WirtzRaphael/thesis_sensornode/sensornode_v2.0.X-HW/project_output/bom/bill_of_material_sensornode_v2_orderlist.xlsx

Name | Value | Designator | Footprint | LibRef | Quantity | Supplier 1 | Supplier Part Number 1 | Supplier Unit Price 1 | Quantity 4PCB’s | Price | Order 2736: Mouser | Order 2737: Digikey | Vorhanden 05-06
Battery |  | B200 | JST-S2B-PH-K-S_V - Cloned | Battery | 1 |  |  |  |  | 0
1µF | 1µF | C200, C201, C206, C208, C301, C309 | 0402, 0603 | C | 6 | Mouser | 581-04026D105KAT2A | 0.035 | 24 | 0.84 | x
Capacitor 0402 | 10uF | C202 | 0603 | C | 1 | Mouser | 81-GRM188R60J106KE7J | 0.1 | 4 | 0.4 | x
Capacitor 0603 | 22uF | C203, C204 | 0603 | C | 2 | Mouser | 81-GRM188R60J226ME0D | 0.15 | 8 | 1.2 | x
100nF, [NoValue] | 100nF | C205, C207, C209, C313, C314, C315, C316, C317, C318, C400, C401 | 0603 | C | 11 | Mouser | 80-C0603C104K9R | 0.055 | 44 | 2.42 | 0
Capacitor 0402 | 100nF | C210, C300, C302, C303, C304, C305, C306, C307, C308, C310, C311 | 0402 | C | 11 | Mouser | 581-0402X7R104KT7AT | 0.172 | 44 | 7.568 | x
Capacitor 0603 | 100nF | C700, C701, C702, C703, C704 | 0603 | C | 5 | Mouser | 80-C0603X104K1RAUTO | 0.24 | 20 | 4.8 | 0
PMEG2010ER | PMEG2010ER | D200, D202 | SODFL3517X110N | Schotky_1 | 2 | Mouser | 771-PMEG2010ER115 | 0.4 | 8 | 3.2 | x
Orange |  | D201, D401 | 0603-Diode | LED_1 | 2 | Mouser | 630-HSMD-C191 | 0.46 | 8 | 3.68 | x
BAS40-05 | BAS40-05 | D203 | SOT-23 | Schotky_BAS40-5 | 1 | Mouser | 726-BAS4005E6327HTSA | 0.33 | 4 | 1.32 | x
Red |  | D400, D802 | 0603-Diode | LED_1 | 2 | Mouser | 630-HSMC-C191 | 0.61 | 8 | 4.88 | x
Green |  | D800 | 0603-Diode | LED_1 | 1 | Mouser | 630-HSMG-C191 | 0.4 | 4 | 1.6 | x
750mA |  | F800 | 1206 | FUSE_1 | 1 | Mouser | 652-MF-NSMF075/8X-2 | 0.6 | 4 | 2.4 | x
HEADER_2x1_TD |  | J200, J201, J202, J203, J204 | HEADER_2_RM_2.54 | HEADER_2x1_TD | 5 |  |  |  | 20 | 0 | 0
RF_LPRS_x2 |  | J400 |  | RF_LPRS_x2 | 1 | Mouser | 471-SMARACONNECTORWP | 7.38 | 4 | 29.52 | x
HEADER_5x2_LR |  | J402, J804 | HEADER_SMD_1.27 | HEADER_5x2_LR | 2 | Mouser | 710-62101021021 | 1.4 | 8 | 11.2 | x
I2C - TMP117 |  | J600_TEMP1, J600_TEMP2 | JST_S4B-PH-K-S(LF)(SN) | CON4 | 2 |  |  |  | 8 | 0 | 0
CON3 |  | J700 | JST_S3B-PH-K-S(LF)(SN) | CON3 | 1 |  |  |  | 4 | 0 | 0
USB-C | USB4105-GF-A | J800 | USB_GCT_4105-GF-A | USB-C_2 | 1 | Mouser | 640-USB4105-GF-A | 0.827 | 4 | 3.308 | x
0.47uH |  | L200 | FP-XFL4015-MFG | L? | 1 | Mouser | 81-1276AS-H-R47MP2 | 0.4 | 4 | 1.6 | x
BLM18SG331TN1 |  | L201 | 1608X65N_BEADC | L? | 1 | Mouser | 81-BLM18SG331TN1D | 0.13 | 4 | 0.52 | x
M3 | M3 | MTH100, MTH101, MTH102, MTH103 |  | MOUNT_TH | 4 |  |  |  | 16 | 0 | 0
DMP3099LQ |  | Q200 | SOT-23 - FET | MOSFET P | 1 | Mouser | 621-DMP3099LQ-7 | 0.35 | 4 | 1.4 | x
270 | 270 | R200 | 0603 | R? | 1 | Mouser | 667-ERA-3AED271V | 0.17 | 4 | 0.68
511k |  | R201 | 0603 | R? | 1 | Mouser | 71-CRCW0603-511K-E3 | 0.1 | 4 | 0.4
91k |  | R202 | 0603 | R? | 1 | Mouser | 667-ERA-3AED913V | 0.12 | 4 | 0.48
24k |  | R203 | 0603 | R? | 1 |  |  |  | 4 | 0
1k5 |  | R204 | 0603 | R? | 1 | Mouser | 667-ERA-3AED152V | 0.12 | 4 | 0.48
8.2k |  | R205 | 0603 | R? | 1 | Mouser | 667-ERA-3AED822V | 0.12 | 4 | 0.48
10k |  | R206, R210 | 0603 | R? | 2 | Mouser | 667-ERA-2ARB103X | 0.73 | 8 | 5.84
100k |  | R207, R209, R213, R305 | 0603 | R? | 4 | Mouser | 667-ERA-3AED104V | 0.12 | 16 | 1.92
330k |  | R214 | 0603 | R? | 1 | Mouser | 667-ERA-3AEB334V | 0.13 | 4 | 0.52
DNP |  | R300, R301, R303, R304 | 0603 | R? | 4 |  |  |  | 16 | 0
27 |  | R306, R307 | 0603 | R? | 2 | Mouser | 667-ERA-3AHD270V | 0.12 | 8 | 0.96
4k7 |  | R308, R309 | 0603 | R? | 2 | Mouser | 667-ERA-3AED472V | 0.12 | 8 | 0.96
1k |  | R310 | 0603 | R? | 1 | Mouser | 667-ERA-3AED102V | 0.14 | 4 | 0.56
5k6 |  | R400 | 0603 | R? | 1 | Mouser | 667-ERA-3AEB562V | 0.13 | 4 | 0.52
8k2 (DNP) |  | R401 | 0603 | R? | 1 | Mouser | 667-ERA-3AED822V | 0.12 | 4 | 0.48
0 |  | R402 | 0603 | R? | 1 |  |  |  | 4 | 0
150 DNP |  | R403, R404 | 0603 | R? | 2 | Mouser | 667-ERA-3AEB151V | 0.13 | 8 | 1.04
5k1 |  | R803, R804 | 0603 | R? | 2 | Digikey | P5.1KDBCT-ND | 0.13 | 8 | 1.04
120 | 120 | R805, R807 | 0603 | R? | 2 |  |  |  | 8 | 0
BOOTSEL |  | SW300 | SWITCH_B3FS1010P | SW_TACTILE_1 | 1 | Mouser | 653-B3FS-1010P | 0.64 | 4 | 2.56 | x
B3U-1000P-B |  | SW400 | OMRON-B3U-1000P-2-B_V | CMP-011-00011-1 | 1 | Mouser | 653-B3U-1000P-B | 1.02 | 4 | 4.08 | x
SW_TACTILE_1 |  | SW800, SW801 | SWITCH_B3FS1010P | SW_TACTILE_1 | 2 | Mouser | 653-B3FS-1010P | 0.64 | 8 | 5.12 | x
TP_SMD |  | TP202, TP203, TP300, TP301 | TP+245X165 | Testpoint | 4 | Mouser | 279-RCT-0C | 0.23 | 16 | 3.68 | x
IC_BQ25172DSGR |  | U200 | IC_BQ25172DSGR | IC_BQ25172DSGR | 1 | Mouser | 595-BQ25172DSGR | 0.94 | 4 | 3.76 | x
TPS63802DLAR |  | U201 | VREG_TPS63802DLAR | TPS63802DLAR | 1 | Mouser | 595-TPS63802DLAR | 2.5 | 4 | 10 | x
TPS22860DBVR |  | U202 | SOT95P280X145-6N | TPS22860DBVR | 1 | Mouser | 595-TPS22860DBVR | 0.95 | 4 | 3.8 | x
SN74AUP1G32 | SN74AUP1G32 | U203 | SOT23-5 | Gatter OR1x2_1 SN74AUP1G32 | 1 | Mouser | 595-SN74AUP1G32DCKR | 0.4 | 4 | 1.6 | x
TPS22908 | TPS22908 | U204 | BGA4C50P2X2_88X88X62N | TPS22908 | 1 | Mouser | 595-TPS22908YZTT | 1.27 | 4 | 5.08 | x
PCF85063ATL/1,118 |  | U205 | 10-DFN(2.6X2.6) | PCF85063ATL/1,118 | 1 | Mouser | 771-PCF85063ATL1118 | 0.94 | 4 | 3.76 | 0
TCA9406 |  | U300 | VSSOP_SOP50P310X90-8N | IC_TCA9406 | 1 | Mouser | 595-TCA9406DCUR | 0.93 | 4 | 3.72 | x
RP2040_2 |  | U301 | QFN40P700X700X90-57N | RP2040_2 | 1 | Mouser | 358-SC09147 | 0.8 | 4 | 3.2 | 0 |  | 5
W25Q16JVUXIQ |  | U302 | SON50P300X200X60-9N | W25Q16JVUXIQ | 1 |  |  |  | 4 | 0 | 0 |  | 5
TXU0102PWR |  | U303 | VFSOP-8 | IC_TXU0102 | 1 | Mouser | 595-TXU0102DCUR | 0.84 | 4 | 3.36 | x
TXU0104PWR |  | U304 | TSSOP-14 | IC_TXU0204_TSSOP | 1 | Mouser | 595-TXU0104PWR | 0.83 | 4 | 3.32 | x
RC1701HP-RC232 |  | U400 | RF_RC1701HP | RC1701HP-RC232 | 1 | Digikey | 1783-RC1701HP-RC232CT-ND | 30.45 | 4 | 121.8 | 3 | x | 1
MAX3221 SSOP |  | U700 | SSOP_SOP65P780X200-16N | RS232_MAX3221E_TI_TSSOP | 1 | Mouser | 595-MAX3221IDBR | 0.83 | 4 | 3.32 | x
ESD_USBLC6-2SC6_1 |  | U800 | SOT95P280X145-6N | ESD_USBLC6-2SC6_1 | 1 | Mouser | 511-USBLC6-2SC6 | 0.35 | 4 | 1.4 | x
SC32S-7PF20PPM | SC32S-7PF20PPM | Y200 | SC32S7PF20PPM | Crystal_1 | 1 | Mouser | 628-SC32S-7PF20PPM | 0.38 | 4 | 1.52 | x
CSTNE12M0GH5L000R0 | CSTNE12M0GH5L000R0 | Y300 | OSC_CSTNE12M0GH5L000R0 | Crystal_3 | 1 | Mouser | 81-CSTNE12M0GH5L000R | 0.3337 | 4 | 1.3348 | x
 |  |  |  |  |  |  |  | 0 |  | 284.6308
