WirtzRaphael/thesis_sensornode/sensornode_v2.0.X-HW/project_output/bom/bill_of_material_sensornode_v2.xlsx

Name | Description | value | Footprint | Quantity | Manufacturer 1 | Manufacturer Part Number 1 | Manufacturer 2 | Manufacturer Part Number 2 | Supplier Subtotal 2 | Designator
Battery |  |  | HEADER_2_RM_2.54 | 1 |  |  |  |  |  | B200
1µF | Capacitor 0402 | 1µF | 0402 | 6 | jlcpcb | C162161 |  |  |  | C200, C201, C206, C208, C301, C309
Capacitor 0402 | Capacitor 0402 | 10uF | 0603 | 1 |  |  |  |  |  | C202
Capacitor 0603 |  | 22uF | 0603 | 2 |  |  |  |  |  | C203, C204
100n | Capacitor 0402 | 100n | 0603 | 1 |  |  |  |  |  | C205
100nF, Capacitor 0402 | Capacitor 0402 | 100nF | 0402 | 21 | jlcpcb | C363530 |  |  |  | C207, C209, C210, C300, C302, C303, C304, C305, C306, C307, C308, C310, C311, C312, C313, C314, C315, C316, C317, C400, C401
Capacitor 0603 | Capacitor 0603 | 100nF | 0603 | 5 |  |  |  |  |  | C700, C701, C702, C703, C704
PMEG2010ER |  | PMEG2010ER | SODFL3517X110N | 2 | jlcpcb | C82288 |  |  |  | D200, D202
TBD |  |  | 0603-Diode | 1 |  |  |  |  |  | D201
BAS40-05 |  | BAS40-05 | SOT-23 | 1 | Infineon | BAS40-05E-6327 |  |  |  | D203
White |  |  | 0603-Diode | 2 | jlcpcb | none |  |  |  | D400, D802
Orange |  |  | 0603-Diode | 2 | jlcpcb | C601658 |  |  |  | D401, D801
Green |  |  | 0603-Diode | 1 | jlcpcb | C125094 |  |  |  | D800
HEADER_2x1_TD |  |  | HEADER_2_RM_2.54 | 9 |  |  |  |  |  | J200, J201, J202, J203, J204, J400, J801, J802, J803
HEADER_5x2_LR |  |  | CON_2x5_RM1.27_tht | 2 |  |  |  |  |  | J402, J804
I2C - TMP117 |  |  | HEADER_4_RM_2.54 | 2 |  |  |  |  |  | J600_TEMP1, J600_TEMP2
RS232 |  |  | HEADER_2_RM_2.54 | 1 |  |  |  |  |  | J700
USB-C | Connector 24 (16+8 Dummy) | USB4105-GF-A | USB_GCT_4105-GF-A | 1 | jlcpcb | C3020560 |  |  |  | J800
0.47uH |  |  | FP-XFL4015-MFG | 1 | jlcpcb | C2044584 |  |  |  | L200
BLM18SG331TN1 | 330 Ohms @ 100 MHz 1 Power Line Ferrite Bead 0603 (1608 Metric) 1.5A 70mOhm |  | 1608X65N_BEADC | 1 | jlcpcb | C88989 |  |  |  | L201
M3 |  | M3 |  | 4 | jlcpcb | none |  |  |  | MTH100, MTH101, MTH102, MTH103
DMP3099LQ |  |  | SOT-23 - FET | 1 |  |  |  |  |  | Q200
TBD | Normaler Widerstand |  | 0603 | 3 |  |  |  |  |  | R200, R805, R806
511k | Normaler Widerstand |  | 0603 | 1 |  |  |  |  |  | R201
91k | Normaler Widerstand |  | 0603 | 1 |  |  |  |  |  | R202
24k | Normaler Widerstand |  | 0603 | 1 |  |  |  |  |  | R203
1k5 | Normaler Widerstand |  | 0603 | 1 |  |  |  |  |  | R204
8.2k | Normaler Widerstand |  | 0603 | 1 |  |  |  |  |  | R205
10k | Normaler Widerstand |  | 0603 | 6 |  |  |  |  |  | R206, R210, R211, R800, R801, R802
100k | Normaler Widerstand |  | 0603 | 4 |  |  |  |  |  | R207, R209, R213, R305
DNP | Normaler Widerstand |  | 0603 | 6 |  |  |  |  |  | R208, R212, R300, R301, R303, R304
330k | Normaler Widerstand |  | 0603 | 1 |  |  |  |  |  | R214
5k1 | Normaler Widerstand |  | 0603 | 3 |  |  |  |  |  | R302, R803, R804
27 | Normaler Widerstand |  | 0603 | 2 |  |  |  |  |  | R306, R307
4k7 | Normaler Widerstand |  | 0603 | 2 |  |  |  |  |  | R308, R309
1k | Normaler Widerstand |  | 0603 | 1 |  |  |  |  |  | R310
5k6 | Normaler Widerstand |  | 0603 | 1 |  |  |  |  |  | R400
8k2 (DNP) | Normaler Widerstand |  | 0603 | 1 |  |  |  |  |  | R401
0 | Normaler Widerstand |  | 0603 | 1 |  |  |  |  |  | R402
150 DNP | Normaler Widerstand |  | 0603 | 2 |  |  |  |  |  | R403, R404
68 | Normaler Widerstand |  | 0603 | 1 |  |  |  |  |  | R807
Bootsel, B3U-1000P-B | Ultra-small Surface-mounting Tactile Switches with High Contact Reliability, SPST-NO, -25 to 70 degC, 2-Pin SMD, RoHS, Tape and Reel |  | OMRON-B3U-1000P-2-B_V | 2 | jlcpcb | C231329 |  |  |  | SW300, SW400
TP_SMD | Testpoint |  | TP+245X165 | 4 | jlcpcb | C9900017596 |  |  |  | TP200, TP201, TP300, TP301
IC_BQ25172DSGR | Charge IC. 0.8-A, one- to six-cell NiMH stand-alone linear charger in a QFN package |  | IC_BQ25172DSGR | 1 | jlcpcb | C5189434 |  |  |  | U200
TPS63802DLAR |  |  | VREG_TPS63802DLAR | 1 | jlcpcb | C2845237 |  |  |  | U201
TPS22919DCKR | 5.5-V, 1.5-A, 90-mΩ load switch with adj. output discharge | TPS22919DCKR | SOT65P210X110-6N | 2 | jlcpcb | C2149796 |  |  |  | U202, U204
SN74LVC1T45 |  | SN74LVC1T45 | SOT23-5 | 1 |  |  |  |  |  | U203
PCF85063ATL/1,118 | Real Time Clock (RTC) IC Clock/Calendar - IÂ²C, 2-Wire Serial 10-XFDFN Exposed Pad |  | 10-DFN(2.6X2.6) | 1 | jlcpcb | C404360 |  |  |  | U205
TCA9406 | 2-bit bidirectional 1MHz I2C/SMBus voltage level translator with internal pull-up resistor |  | TSSOP-14 | 1 |  |  |  |  |  | U300
RP2040_2 | RP2040 chip for Raspberry Pi Pico - ARMÂ® CortexÂ®-M0+ MCU 32-Bit |  | QFN40P700X700X90-57N | 1 | jlcpcb | C2040 |  |  |  | U301
W25Q128JVPIQ | No Description Available |  | WSON_128JVPIQ_WIN | 1 | jlcpcb | C190862 |  |  |  | U302
TXU0102 | Dual-channel fixed multidirectional level shifter |  | VFSOP-8 | 1 |  |  |  |  |  | U303
TXU0104 | Four-channel fixed multidirectional level shifter |  | TSSOP-14 | 1 |  |  |  |  |  | U304
RC1701HP-RC232 |  |  | RF_RC1701HP | 1 | jlcpcb | none |  |  |  | U400
MAX3221EIDBR SSOP |  |  | SOP65P780X200-16N | 1 | jlcpcb | C543018 |  |  |  | U700
SC32S-7PF20PPM | Crystal | SC32S-7PF20PPM | SC32S7PF20PPM | 1 | jlcpcb | C5452100 |  |  |  | Y200
CSTNE12M0GH5L000R0 | SMT Crystal | CSTNE12M0GH5L000R0 | OSC_CSTNE12M0GH5L000R0 | 1 | jlcpcb | C2650803 |  |  |  | Y300
