WirtzRaphael/thesis_sensornode/sensornode_v2.0.X-HW/project_output/jlcpcb_assembly/Bill of Materials jlcpcb-sensornode_v2.xlsx

Name | Designator | Footprint | Manufacturer Part Number 1 | jlcpcb_nr
Battery | B200 | HEADER_2_RM_2.54
1µF | C200, C201, C203, C207, C208, C303, C311 | 0402 | C162161
Capacitor 0402, 100nF | C202, C209, C210, C302, C304, C305, C306, C307, C308, C309, C310, C312, C313, C400, C401 | 0402 | C363530
Capacitor 0603 | C204, C205 | 0805_S
Capacitor 0402 | C206 | 0805_S
Capacitor 0603 | C700, C701, C702, C703, C704 | 0805_S
TBD | D200 | 0805_S_DIODE
PMEG2010ER | D201 | SODFL3517X110N | C82288
White | D401, D802 | 0603-Diode | C601658
Orange | D402, D801 | 0603-Diode | C601658
Green | D800 | 0603-Diode | C125094
HEADER_2x1_TD | J201, J202, J203, J400, J401, J802, J803, J804 | HEADER_2_RM_2.54
HEADER_5x2_LR | J402, J801 | CON_2x5_RM1.27_tht
I2C - TMP117 | J600_TEMP1, J600_TEMP2, J600_TEMP3, J600_TEMP4 | HEADER_4_RM_2.54
RS232 | J700 | HEADER_2_RM_2.54
USB-C | J800 | USB_GCT_4105-GF-A | C3020560
0.47uH | L200 | 1210 | C2044584
BLM18SG331TN1 | L400 | 1608X65N_BEADC | C88989
M3 | MTH100, MTH101, MTH102, MTH103
DMP4065S-7 | Q200 | SOT-23 - FET | DMP4065S-7
TBD | R200, R208, R209, R211, R805, R806 | 0805_S
100k | R201, R202, R203, R206 | 0805_S
DNP | R204, R214, R215 | 0805_S
0 | R205, R402 | 0805_S
? | R207 | 0805_S
10k | R210, R802, R803, R804 | 0805_S
511k | R212 | 0805_S
91k | R213 | 0805_S
4k7 | R300, R301, R302, R303 | 0805_S
27 | R304, R305 | 0805_S
1k | R310 | 0805_S
5k6 | R400 | 0805_S
8k2 (DNP) | R401 | 0805_S
150 DNP | R403, R404 | 0805_S
5k1 | R800, R801 | 0805_S
68 | R807 | 0805_S
B3U-1000P-B | SW300, SW400 | OMRON-B3U-1000P-2-B_V | C231329
TP_SMD | TP200, TP201, TP202, TP203, TP204, TP205, TP206, TP207, TP208, TP300, TP301, TP302, TP303, TP400, TP401 | TP+245X165 | C9900017596
PCF85063ATL/1,118 | U200 | 10-DFN(2.6X2.6) | C404360
TPS22919DCKR | U201, U202 | SOT65P210X110-6N | C2149796
TPS63802DLAR | U203 | VREG_TPS63802DLAR | C2845237
74AHC1G32 | U204 | SC-70-6
IC_BQ25172DSGR | U205 | IC_BQ25172DSGR | C5189434
RP2040_2 | U300 | QFN40P700X700X90-57N | C2040
W25Q128JVPIQ | U301 | WSON_128JVPIQ_WIN | C190862
RC1701HP-RC232 | U400 | RF_RC1701HP | RC1701HP-RC232
MAX3221EIDBR SSOP | U700 | SOP65P780X200-16N | C543018
SC32S-7PF20PPM | Y200 | SC32S7PF20PPM | C5452100
CSTNE12M0GH5L000R0 | Y300 | OSC_CSTNE12M0GH5L000R0 | C2650803
