WirtzRaphael/thesis_sensornode/sensornode_poc_rtc/output_doc/sensornode_poc.PDF

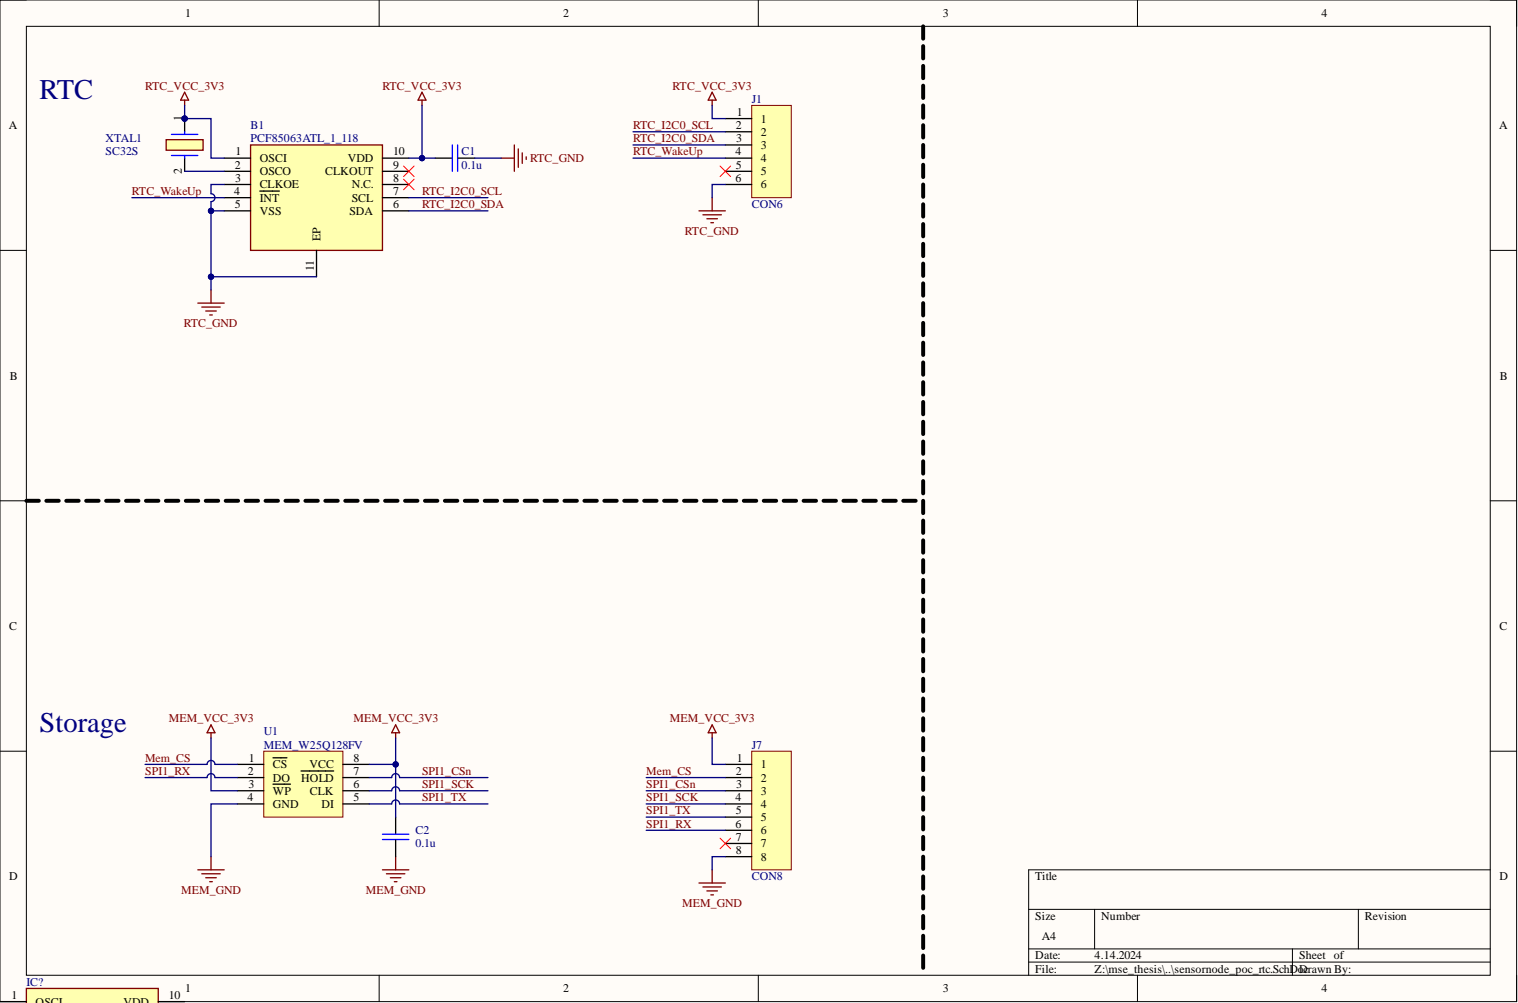
[picture p1: page 1]

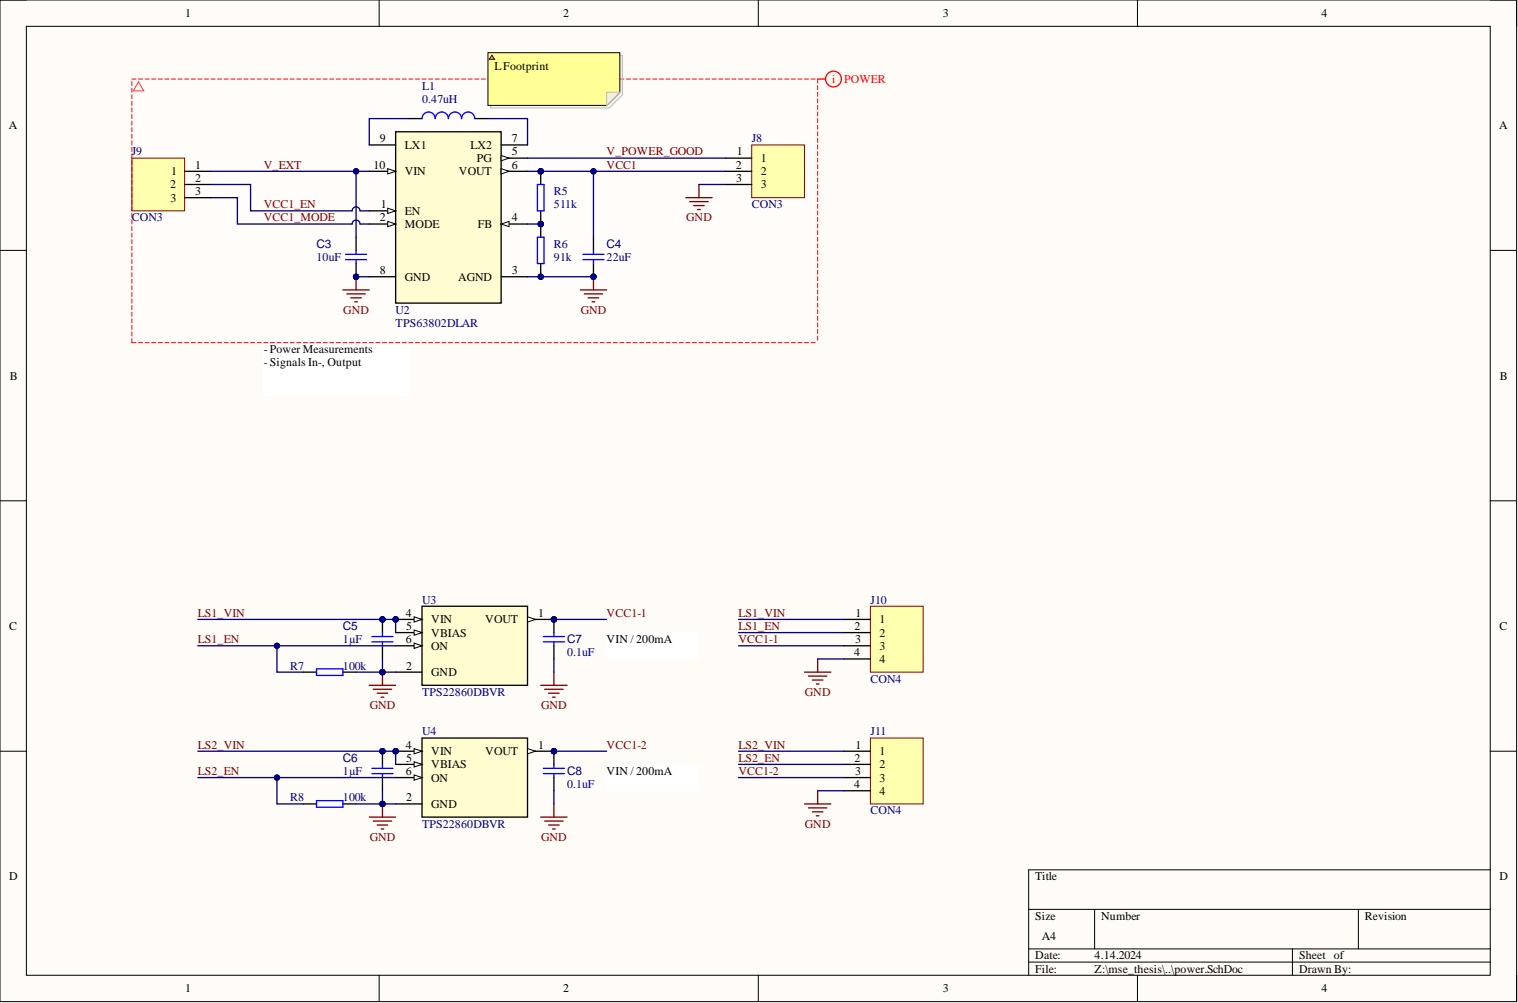
[picture p2: page 2]

VCC1_EN
VCC1_MODE | | MODE 2
