WirtzRaphael/thesis_sensornode/(list of files, drawings)

Other design files:
sensornode_poc_rtc/power.SchDoc
sensornode_poc_rtc/sensornode_poc_rtc.PcbDoc
sensornode_poc_rtc/sensornode_poc_rtc.PrjPcb
sensornode_poc_rtc/sensornode_poc_rtc.SchDoc
sensornode_v2.0.X-HW/display.SchDoc
sensornode_v2.0.X-HW/ios.SchDoc
sensornode_v2.0.X-HW/mcu.SchDoc
sensornode_v2.0.X-HW/power.SchDoc
sensornode_v2.0.X-HW/radio.SchDoc
sensornode_v2.0.X-HW/sensornode_v2.PcbDoc
sensornode_v2.0.X-HW/sensornode_v2.PrjPcb
sensornode_v2.0.X-HW/sensornode_v2.SchDoc
sensornode_v2.0.X-HW/sensornode_v2.SCHLIB
sensornode_v2.0.X-HW/temperature.SchDoc
