WirtzRaphael/thesis_sensornode/(commit log)

2024-02-25 add: project sensornode poc rtc
    [sensornode_poc_rtc.PcbDoc, sensornode_poc_rtc.PrjPcb, sensornode_poc_rtc.SchDoc]
2024-02-27 update: pcb routed and component placed
    [sensornode_poc_rtc.PcbDoc]
2024-02-27 update: pcb components
    [sensornode_poc_rtc.SchDoc]
2024-04-05 add project sensornode hw v2
    [mcu.SchDoc, power.SchDoc, radio.SchDoc, sensornode_v2.PrjPcb, sensornode_v2.SCHLIB, sensornode_v2.SchDoc]
2024-04-06 update: power
    [power.SchDoc]
2024-04-06 power: restructure
    [power.SchDoc]
2024-04-06 add: display, sensors temperature
    [display.SchDoc, temperature.SchDoc]
2024-04-06 add pcb
    [sensornode_v2.PcbDoc]
2024-04-06 update schemas and project
    [mcu.SchDoc, power.SchDoc, radio.SchDoc, sensornode_v2.PrjPcb]
2024-04-09 update schema
    [sensornode_v2.PrjPcb]
2024-04-09 add schema for I/Os
    [ios.SchDoc]
2024-04-09 update: fix altium problems; connections etc.
    [ios.SchDoc, mcu.SchDoc, power.SchDoc, radio.SchDoc, sensornode_v2.SchDoc]
2024-04-09 update: project settings and connections checks
    [sensornode_v2.PrjPcb]
2024-04-09 update: schema lib project
    [sensornode_v2.SCHLIB]
2024-04-09 update: pcb grouped
    [sensornode_v2.PcbDoc]
2024-04-11 update project
    [ios.SchDoc, mcu.SchDoc, power.SchDoc, radio.SchDoc, sensornode_v2.PcbDoc, sensornode_v2.PrjPcb, sensornode_v2.SCHLIB, sensornode_v2.SchDoc]
2024-04-12 update: project parameters
    [ios.SchDoc, mcu.SchDoc, power.SchDoc, radio.SchDoc, sensornode_v2.PrjPcb, sensornode_v2.SchDoc, temperature.SchDoc]
2024-04-13 update: poc project and pcb
    [power.SchDoc, sensornode_poc_rtc.PcbDoc, sensornode_poc_rtc.PrjPcb, sensornode_poc_rtc.SchDoc]
2024-04-15 add: active BOM
2024-04-15 update: components and bom
    [mcu.SchDoc, power.SchDoc, radio.SchDoc, sensornode_v2.PcbDoc, sensornode_v2.PrjPcb, sensornode_v2.SCHLIB, sensornode_v2.SchDoc]
2024-04-15 replace dc/dc converter, use TPS63802DLAR
    [power.SchDoc]
2024-04-15 replace USB-C connector
    [ios.SchDoc]
2024-04-15 replace crystal for mcu
    [mcu.SchDoc]
2024-04-15 update components and libraries
    [sensornode_v2.PcbDoc, sensornode_v2.PrjPcb, sensornode_v2.SCHLIB]
2024-04-17 update schematic
    [ios.SchDoc, mcu.SchDoc, power.SchDoc, radio.SchDoc, sensornode_v2.PcbDoc, sensornode_v2.PrjPcb, sensornode_v2.SCHLIB, sensornode_v2.SchDoc]
2024-04-17 add: bom
    [bill_of_material_sensornode_v2.xlsx]
2024-04-17 update bom
2024-04-19 sync top sheet
    [sensornode_v2.SchDoc]
2024-04-24 pcb: grobplatzierung
    [sensornode_v2.PcbDoc]
2024-04-25 update: schema
    [ios.SchDoc, mcu.SchDoc, power.SchDoc, radio.SchDoc, sensornode_v2.PrjPcb, sensornode_v2.SCHLIB, sensornode_v2.SchDoc, temperature.SchDoc]
2024-04-28 rp2040 rotated
    [sensornode_v2.PcbDoc]
2024-05-01 udpate pcb
    [sensornode_v2.PcbDoc]
2024-05-01 schema: add usb esd protection
    [ios.SchDoc, mcu.SchDoc]
2024-05-01 update pcb - vias - polygons - routing
    [sensornode_v2.PcbDoc]
2024-05-02 update pcb
    [sensornode_v2.PcbDoc]
2024-05-02 update schematics
    [ios.SchDoc, mcu.SchDoc, power.SchDoc, radio.SchDoc, sensornode_v2.PcbDoc, sensornode_v2.PrjPcb, sensornode_v2.SCHLIB]
2024-05-03 update pcb for release
    [ios.SchDoc, mcu.SchDoc, power.SchDoc, sensornode_v2.PcbDoc, sensornode_v2.PrjPcb, sensornode_v2.SCHLIB]
2024-05-03 update pcb for manufacturing
    [Bill of Materials jlcpcb-sensornode_v2.xlsx, Pick Place for sensornode_v2.csv, bill_of_material_sensornode_v2.xlsx, sensornode_v2.PcbDoc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]
2024-05-03 pcb status for manufacturing
    [sensornode_v2.PcbDoc]
2024-05-06 fabrication files pcbway
    [sensornode_v2.GBL, sensornode_v2.GBO, sensornode_v2.GBS, sensornode_v2.GTL, sensornode_v2.GTO, sensornode_v2.GTS]
2024-05-06 update material order
    [sensornode_v2.PrjPcb]
2024-06-11 update pcb schema and revision E
    [mcu.SchDoc, radio.SchDoc, sensornode_v2.PrjPcb, sensornode_v2.SCHLIB]
2024-06-12 update poc
    [power.SchDoc, sensornode_poc_rtc.PcbDoc, sensornode_poc_rtc.PrjPcb, sensornode_poc_rtc.SchDoc]
2024-06-12 update v2 pcb
    [mcu.SchDoc, sensornode_v2.PcbDoc, sensornode_v2.PrjPcb]
